mirkohahn/hasabrewery-client-esp-temp/additional_assets/WireDiagram_Client_Temp_MINIMUM.jpg

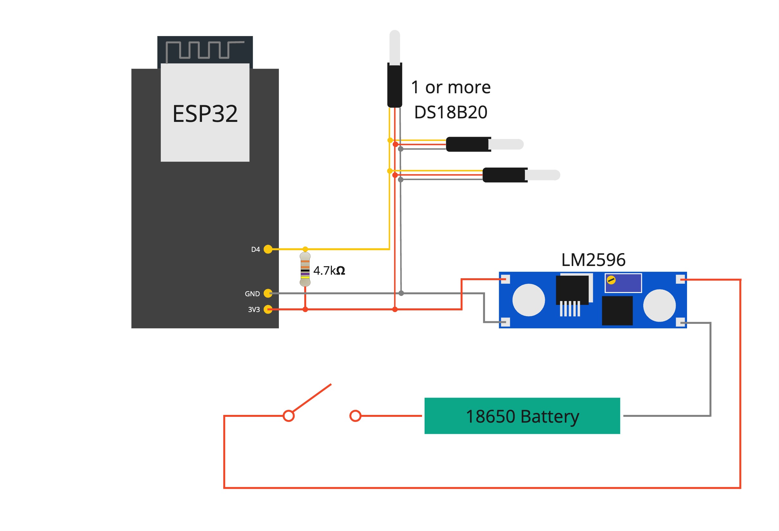
additional_assets/WireDiagram_Client_Temp_MINIMUM.jpg
