mirkohahn/hasabrewery-client-esp-temp/(threads)

Thread 1 (2025-03-15):

Goose Copilot app

tjbart, 2025-03-15:
Hi Mirko

Do you have plans to continue developing / supporting Goose Copilot app / Aerosys ?

I see you are actively working on this project … but hoping you aren’t giving up on Goose copilot app?

Closed 2025-03-17.

Thread 2 (2025-04-17):

Goose development update

tjbart, 2025-04-17:
Hi Mirko

Are we going to get any updates as paid users over at your other app (Goose Copilot)?

https://forum.miralouaero.com/t/future-of-goose-copilot/1876/14

You have a very passionate community behind Goose copilot and paying subscriptions … but there’s radio silence from you / Aerosys.

Surely an update to the community is a fair request?

It’s great that this project is receiving regular attention from you in last few days , but hope the users of Goose aren’t being forgotten about or ignored

K6TU, 2025-04-17:
Seconding this request.
thanks

mirkohahn, 2025-04-17:
hi @tjbart
polishing up the last issues on a new app update & release and will get back to the forum and support request hopefully later today, but tomorrow (Fri) the latest.

thanks for flying with Goose!
Happy Landings

dpcsar, 2025-04-17:
> the next immediate update will be iOS only, as there are a couple bugs in the iOS app, that will be fixed. I hope to be able to give you guys an Android update in the next few weeks

That is awesome!  Let me know what I can do to help test out the update.  I have a couple of Android devices.

Is there a place that I can file bugs?  Can I help with any development?

K6TU, 2025-04-17:
Unless something has changed, I believe the Android version has been removed from the Google app store?

Note that Mirko's comment says **iOS only**

mirkohahn, 2025-04-19:
hi,
the new app version just went thru the app review and was approved. Took Apple a little bit longer than expected, but I'll be answering all forum posts & support emails now
Cheers°

K6TU, 2025-04-19:
I'll send you a screen shot after inland but regret the yes/no is still not displayed. This on a 2024 latest Gen ipad Pro 11.

Thank you for responding. I love the app and appreciate the support.

Stu

- Mis-spellings, typos and grammatical errors courtesy of finger swipes

On Apr 19, 2025, at 9:43 AM, Mirko ***@***.***> wrote:

hi,
the new app version just went thru the app review and was approved. Took Apple a little bit longer than expected, but I'll be answering all forum posts & support emails now
Cheers & Happy Landings

—
Reply to this email directly, view it on GitHub<https://github.com/mirkohahn/hasabrewery-client-esp-temp/issues/2#issuecomment-2816777619>, or unsubscribe<https://github.com/notifications/unsubscribe-auth/AARAVTFYSQ3XWTU4NPM2B3322J4KZAVCNFSM6AAAAAB3KU37JCVHI2DSMVQWIX3LMV43OSLTON2WKQ3PNVWWK3TUHMZDQMJWG43TONRRHE>.
You are receiving this because you are subscribed to this thread.Message ID: ***@***.***>

[https://avatars.githubusercontent.com/u/55064112?s=20&v=4]mirkohahn left a comment (mirkohahn/hasabrewery-client-esp-temp#2)<https://github.com/mirkohahn/hasabrewery-client-esp-temp/issues/2#issuecomment-2816777619>

hi,
the new app version just went thru the app review and was approved. Took Apple a little bit longer than expected, but I'll be answering all forum posts & support emails now
Cheers & Happy Landings

—
Reply to this email directly, view it on GitHub<https://github.com/mirkohahn/hasabrewery-client-esp-temp/issues/2#issuecomment-2816777619>, or unsubscribe<https://github.com/notifications/unsubscribe-auth/AARAVTFYSQ3XWTU4NPM2B3322J4KZAVCNFSM6AAAAAB3KU37JCVHI2DSMVQWIX3LMV43OSLTON2WKQ3PNVWWK3TUHMZDQMJWG43TONRRHE>.
You are receiving this because you are subscribed to this thread.Message ID: ***@***.***>

tjbart, 2025-04-19:
Thanks for the update.  Will download update  shortly.

Looking forward to seeing the official communication on the support forum to the community

K6TU, 2025-04-20:
Still testing but I think it's now working!

I can now see the yes and no, going through all the branches.
I really appreciate this!!!!
Stu

- Mis-spellings, typos and grammatical errors courtesy of finger swipes

On Apr 19, 2025, at 10:00 AM, Stuart Phillips ***@***.***> wrote:

  I'll send you a screen shot after inland but regret the yes/no is still not displayed. This on a 2024 latest Gen ipad Pro 11.

Thank you for responding. I love the app and appreciate the support.

Stu

- Mis-spellings, typos and grammatical errors courtesy of finger swipes

On Apr 19, 2025, at 9:43 AM, Mirko ***@***.***> wrote:

hi,
the new app version just went thru the app review and was approved. Took Apple a little bit longer than expected, but I'll be answering all forum posts & support emails now
Cheers & Happy Landings

—
Reply to this email directly, view it on GitHub<https://github.com/mirkohahn/hasabrewery-client-esp-temp/issues/2#issuecomment-2816777619>, or unsubscribe<https://github.com/notifications/unsubscribe-auth/AARAVTFYSQ3XWTU4NPM2B3322J4KZAVCNFSM6AAAAAB3KU37JCVHI2DSMVQWIX3LMV43OSLTON2WKQ3PNVWWK3TUHMZDQMJWG43TONRRHE>.
You are receiving this because you are subscribed to this thread.Message ID: ***@***.***>

[https://avatars.githubusercontent.com/u/55064112?s=20&v=4]mirkohahn left a comment (mirkohahn/hasabrewery-client-esp-temp#2)<https://github.com/mirkohahn/hasabrewery-client-esp-temp/issues/2#issuecomment-2816777619>

hi,
the new app version just went thru the app review and was approved. Took Apple a little bit longer than expected, but I'll be answering all forum posts & support emails now
Cheers & Happy Landings

—
Reply to this email directly, view it on GitHub<https://github.com/mirkohahn/hasabrewery-client-esp-temp/issues/2#issuecomment-2816777619>, or unsubscribe<https://github.com/notifications/unsubscribe-auth/AARAVTFYSQ3XWTU4NPM2B3322J4KZAVCNFSM6AAAAAB3KU37JCVHI2DSMVQWIX3LMV43OSLTON2WKQ3PNVWWK3TUHMZDQMJWG43TONRRHE>.
You are receiving this because you are subscribed to this thread.Message ID: ***@***.***>

K6TU, 2025-04-20:
Confirmed that:

  1.  Yes/No item now works correctly.
  2.  The Picker item does not display choices either as a picker or as buttons (previously reported)
  3.  Text field input does not work. (previously reported)

Thanks for 6.3.2 – I’ve posted about its availability on the forums.

Would be great if you could respond in person and acknowledge the other issues, even if you can’t yet provide a release date.  It would reinforce that the app is still supported.

Respectfully,
Stu

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

tjbart, 2025-04-22:
> hi, the new app version just went thru the app review and was approved. Took Apple a little bit longer than expected, but I'll be answering all forum posts & support emails now Cheers & Happy Landings

Mirko, Is there any reason this reply isn’t being posted official from yourself on the offical supper forum?

I’ve had quite a few people message me asking if they should stop paying their subscription fee because there’s no offical responses over there. I’m telling them to be patient - but it’s not up to me to do Aerosys support/PR work - it needs to come from you.    I don’t understand why the reluctance to put a simple update over there, whilst in the meantime you loose customers who think there’s no one caring at Aerosys

Closed 2025-04-17.

Thread 8 (2025-07-20):

Goose support forums down

tjbart, 2025-07-20:
Mirko you keep saying that Goose copilot app development  / Aerosys is still active, but now Now along with Aerosys website and support email… the Goose copilot forum is down too?  Is this intentional?  Are you giving up on your fellow aviators?

I really wish you’d stand by what you say on your own LinkedIn profile (below).  Some honesty would be nice please on how we as paid users can actually use this product.
—-

“Together at AeroSys, we gained the global lead in offline voice recognition in aviation.
My experiences enable me to push innovation, communicate visions and get engagement on of levels. I am confident that I can bring smart systems into GA and BA cockpits.
I own my mistakes and learn from them. And I am very proud to say that I did very few mistakes twice.
Aviation enthusiasts and professionals are some of the most passionate and dedicated people you are likely to meet. I am proud to be a part of this community.”

“As I look into the future, I am excited about the possibilities that lie ahead for the aviation industry. I am proud to be a part of this dynamic and ever-evolving field. I will continue to push the boundaries in aviation, especially when it comes to smart pilot assistance systems.
If you are as enthusiastic about digital systems to assist pilots in aviation feel free to connect and share your thoughts.”
