mirkohahn/hasabrewery-client-esp-temp/src/main.cpp

#include <Arduino.h>
#include <ArduinoOTA.h>

#include "main.h"
#include <WiFi.h>
#include "config.h"
#include "led.h"
#include "mqtt_handler.h"
#include "temperature_sensor.h"
#include "battery_monitor.h"
#include "esp_sleep.h"


RTC_DATA_ATTR int bootCount = 0; // Retains count across deep sleep cycles

WiFiServer telnetServer(23);
WiFiClient telnetClient;

void connectToStrongestWiFi()
{
    String hostname = "ConnectedBrewery_" + String(DEVICE_ID);
    WiFi.setHostname(hostname.c_str());

    Serial.println("🔍 Scanning for WiFi networks...");
    led_blink("green", 5, 250, 250);
    int numNetworks = WiFi.scanNetworks();

    if (numNetworks == 0)
    {
        Serial.println("❌ No WiFi networks found!");
        led_off("green");
        led_on("red");
        led_blink("green", 3, 500, 500);
        return;
    }

    int bestNetworkIndex = -1;
    int bestRSSI = -100;  // Start with the lowest possible signal strength
    uint8_t bestBSSID[6]; // Store the BSSID of the strongest AP
    int bestChannel = 0;

    // Find the strongest network that matches our predefined SSID
    for (int i = 0; i < numNetworks; i++)
    {
        String detectedSSID = WiFi.SSID(i);
        int signalStrength = WiFi.RSSI(i);

        Serial.printf("📡 Found: %s (RSSI: %d dBm, Channel: %d)\n",
                      detectedSSID.c_str(), signalStrength, WiFi.channel(i));

        // Check if the detected network matches our predefined SSID
        if (detectedSSID == WIFI_SSID && signalStrength > bestRSSI)
        {
            bestRSSI = signalStrength;
            bestNetworkIndex = i;
            memcpy(bestBSSID, WiFi.BSSID(i), sizeof(bestBSSID));
            bestChannel = WiFi.channel(i);
        }
    }

    // Connect to the best available AP
    if (bestNetworkIndex != -1)
    {
        Serial.printf("✅ Connecting to strongest WiFi AP: %s (RSSI: %d dBm, Channel: %d)...\n",
                      WiFi.SSID(bestNetworkIndex).c_str(), bestRSSI, bestChannel);

        WiFi.begin(WIFI_SSID, WIFI_PASSWORD, bestChannel, bestBSSID, true);

        int attempt = 0;
        while (WiFi.status() != WL_CONNECTED && attempt < 15)
        { // Increase attempts to 15 for better stability
            delay(500);
            Serial.print(".");
            attempt++;
        }

        if (WiFi.status() == WL_CONNECTED)
        {
            Serial.println("\n✅ WiFi connected!");
            led_off("green");
            led_blink("green", 3, 100, 100);
            led_on("green");
            Serial.print("📡 IP Address: ");
            Serial.println(WiFi.localIP());

            Serial.print("🛰️ Connected BSSID: ");
            Serial.printf("%02X:%02X:%02X:%02X:%02X:%02X\n",
                          bestBSSID[0], bestBSSID[1], bestBSSID[2],
                          bestBSSID[3], bestBSSID[4], bestBSSID[5]);

            WiFi.setAutoReconnect(true); // Ensure it reconnects if disconnected
            WiFi.setSleep(false);        // Disable WiFi sleep for stable connection
        }
        else
        {
            Serial.println("\n❌ WiFi connection failed!");
            led_blink("red", 3, 100, 100);
            led_blink("red", 3, 250, 250);
            led_on("red");
        }
    }
    else
    {
        Serial.println("⚠️ No known strong network found. Using default WiFi credentials.");
        WiFi.begin(WIFI_SSID, WIFI_PASSWORD);
        led_blinking("red");
    }
}


void setup()
{

    Serial.begin(115200);
    delay(100);

    // Enabling Optional Features
#if ENABLE_LED
    pinMode(PIN_LED_RED, OUTPUT);
    pinMode(PIN_LED_GREEN, OUTPUT);
    pinMode(PIN_LED_BLUE, OUTPUT);
#endif

    led_on("green");
    delay(500);
    led_on("red");
    delay(500);
    led_on("blue");
    delay(500);
    leds_off();

#if ENABLE_BATTERY_MONITOR
    setupBatteryMonitor();
#endif

    // Connect to the strongest available WiFi
    connectToStrongestWiFi();

    // Enable OTA updates
    ArduinoOTA.setHostname(WiFi.getHostname());
    ArduinoOTA.begin();

    // Start Telnet server
    telnetServer.begin();
    telnetServer.setNoDelay(true);

    // Sync time using NTP
    setupTime();

    // Initialize MQTT
    mqttInit();

    // Initialize DS18B20 sensor
    setupTemperatureSensor();
}

RTC_DATA_ATTR bool in_dev_time = true;
unsigned long previousMillis = 0;

void loop()
{
    unsigned long currentMillis = millis();

    // Disable OTA/Telnet after INITIAL_DEV_TIME
    if (in_dev_time && currentMillis > INITIAL_DEV_TIME)
    {
        in_dev_time = false;
        leds_off();
        conbrew_logln("⏹️ DEV mode expired");

        telnetClient.stop();
        telnetServer.close();
        WiFi.disconnect(true);
    }

    // Accept Telnet client (only during dev window)
    if (in_dev_time && telnetServer.hasClient())
    {
        if (!telnetClient || !telnetClient.connected())
        {
            telnetClient = telnetServer.available();
        }
        else
        {
            WiFiClient rejectClient = telnetServer.available();
            rejectClient.stop();
        }
    }

    if (in_dev_time)
    {
        ArduinoOTA.handle();
    }

    mqttLoop();

#if ENABLE_LED
    led_loop();
#endif

    if (currentMillis - previousMillis >= 1000)
    {
        previousMillis = currentMillis;

        float brewTemp = readBrewTemperature();
        float ambientTemp = readAmbientTemperature();

        conbrew_log("📡 Brew Temperature: ");
        conbrew_log(String(brewTemp, 2));
        conbrew_logln(" °C");

        conbrew_log("📡 Ambient Temperature: ");
        conbrew_log(String(ambientTemp, 2));
        conbrew_logln(" °C");

        publishTemperature(brewTemp, ambientTemp);

        conbrew_logln("🛑 Waiting 2 seconds to ensure MQTT message is sent...");
        delay(2000);

        if (!in_dev_time && SLEEP_TIMER > 0)
        {
            Serial.println("💤 Going to sleep...");
            leds_off();
            esp_sleep_enable_timer_wakeup(SLEEP_TIMER * 1000ULL);
            esp_deep_sleep_start();
        }
        else
        {
            delay(2000); // Keep for debug cycles when sleep is off
        }
    }
}
