mirkohahn/hasabrewery-client-esp-temp/include/temperature_sensor.h

#ifndef TEMPERATURE_SENSOR_H
#define TEMPERATURE_SENSOR_H

#include <Arduino.h>

void setupTemperatureSensor();
float readBrewTemperature();
float readAmbientTemperature();
bool isSensorConnected();

#endif
