mirkohahn/hasabrewery-client-esp-temp/(commit log)

2025-02-08 deep sleep low power mode and config.h in gitignore for improved local development
2025-02-08 feat: added ambient temp, deep_sleep, imperial units - READY TO GOOOO 🚀
2025-02-11 updated WiFi connection, now improved / fixed connection to nearest / strongest access point
    [main.cpp, mqtt_handler.cpp]
2025-02-28 feat: added .ino files to flash the project using the Arduino IDE
2025-04-14 feat: version 1.1.0 - added LED, Battery Gauge, and some more cool stuff
